ggkogkou/bldc-motor-driver/3D/BLM18PG471SN1D.stp

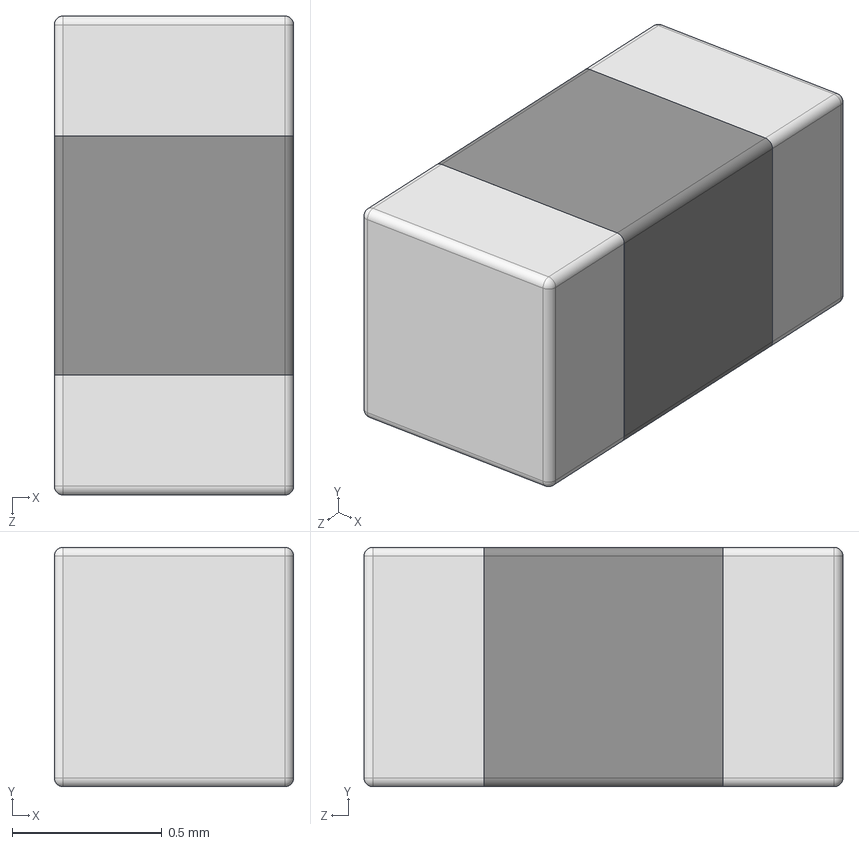
[picture p1: CAD file, 2025-12-28]
3D/BLM18PG471SN1D.stp
0.8 x 0.8 x 1.60 mm
