ggkogkou/bldc-motor-driver/3D/Sandbox/IRLR120NTRPBF.step

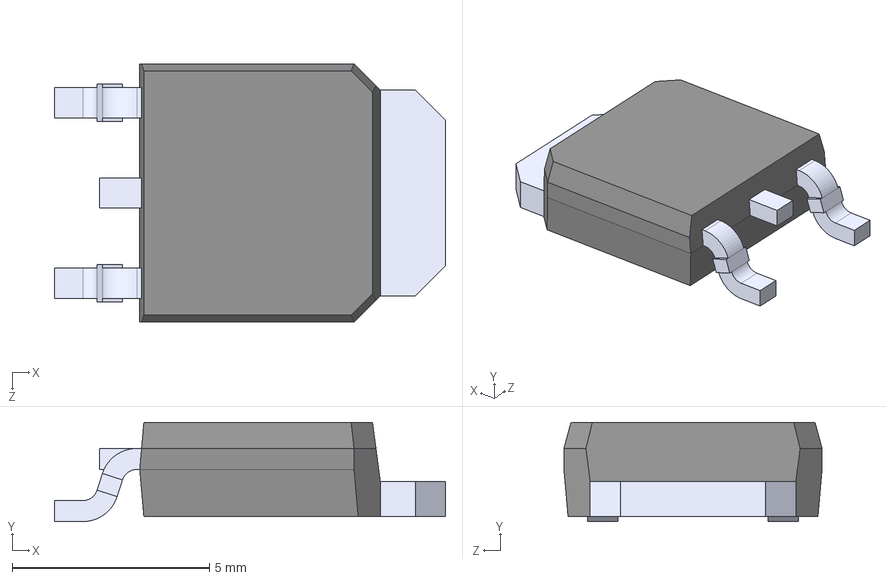
[picture p2: CAD file, 2025-12-05]
3D/Sandbox/IRLR120NTRPBF.step
9.91 x 2.51 x 6.54 mm
