ggkogkou/bldc-motor-driver/3D/Sandbox/IPD320N20N3GATMA1.stp

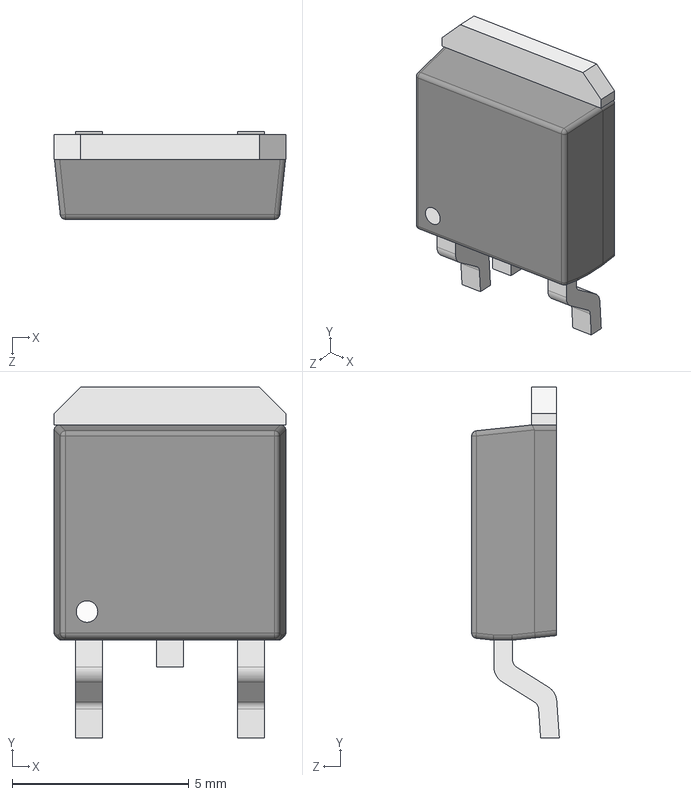
[picture p3: CAD file, 2025-12-05]
3D/Sandbox/IPD320N20N3GATMA1.stp
6.57 x 9.94 x 2.49 mm
