ggkogkou/bldc-motor-driver/3D/Sandbox/STD10NF10T4.stp

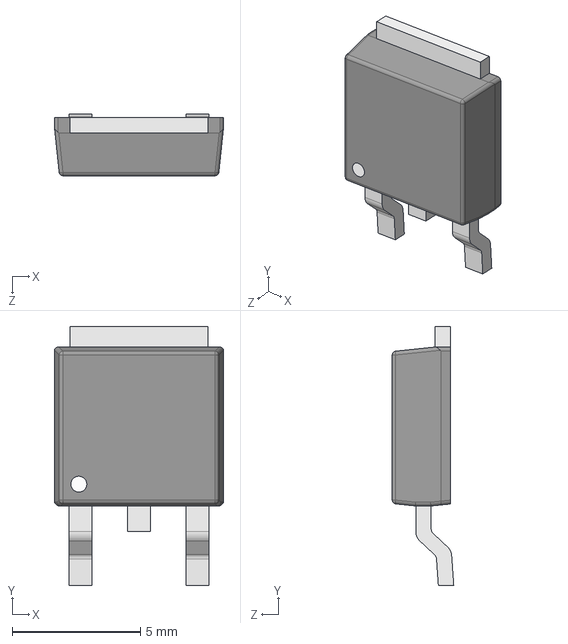
[picture p4: CAD file, 2025-12-05]
3D/Sandbox/STD10NF10T4.stp
6.60 x 10.1 x 2.40 mm
