ggkogkou/bldc-motor-driver/3D/Sandbox/USB3135-30-A.stp

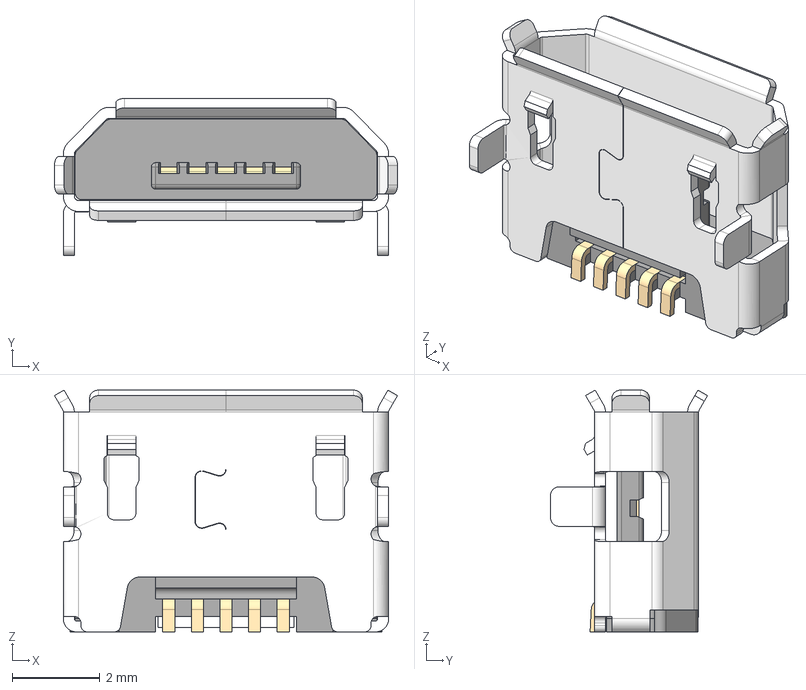
[picture p5: CAD file, 2025-12-05]
3D/Sandbox/USB3135-30-A.stp
7.80 x 3.57 x 5.50 mm
USB3135-30-A_PART1
USB3135-30-A_PART2 x 5
USB3135-30-A_PART3
