ggkogkou/bldc-motor-driver/3D/USB3140-30-0140-1-C.stp

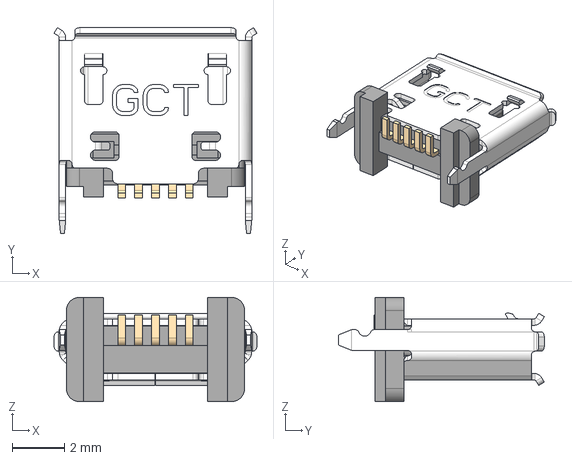
[picture p6: CAD file, 2025-12-12]
3D/USB3140-30-0140-1-C.stp
7.80 x 7.90 x 4.00 mm
