ggkogkou/bldc-motor-driver/3D/AS5047P-ATSM.stp

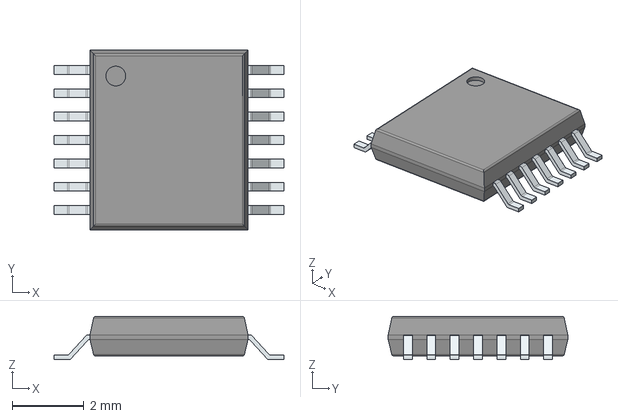
[picture p8: CAD file, 2025-12-03]
3D/AS5047P-ATSM.stp
6.40 x 5.00 x 1.20 mm
PinsArrayLR
