ggkogkou/bldc-motor-driver/3D/ATSAMD21G18A-AFT.stp

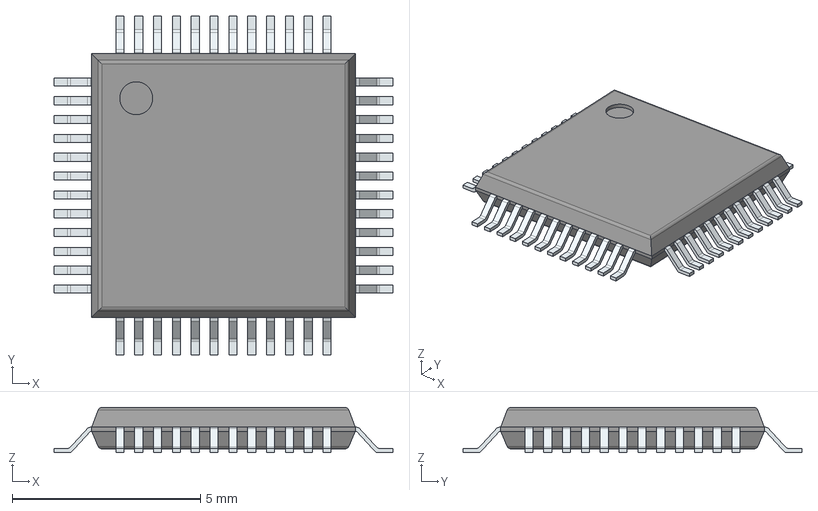
[picture p9: CAD file, 2025-12-03]
3D/ATSAMD21G18A-AFT.stp
9.00 x 9.00 x 1.20 mm
PinsArrayLR
PinsArrayTB
