ggkogkou/bldc-motor-driver/3D/L6498D.stp

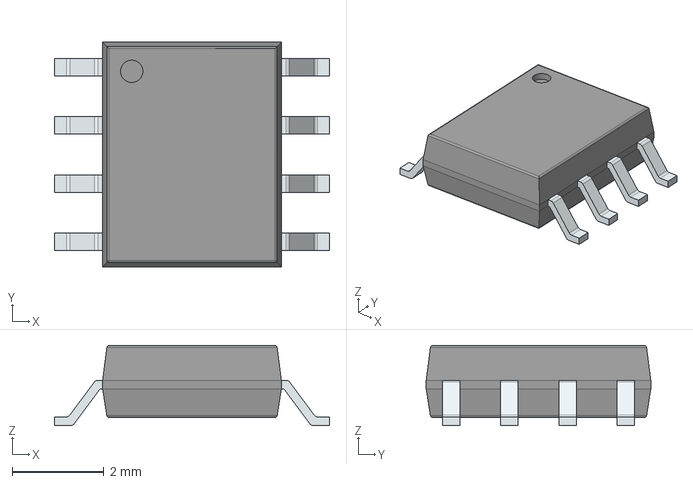
[picture p10: CAD file, 2025-12-03]
3D/L6498D.stp
6.00 x 4.90 x 1.75 mm
PinsArrayLR
