ggkogkou/bldc-motor-driver/3D/IPB320N20N3GATMA1.step

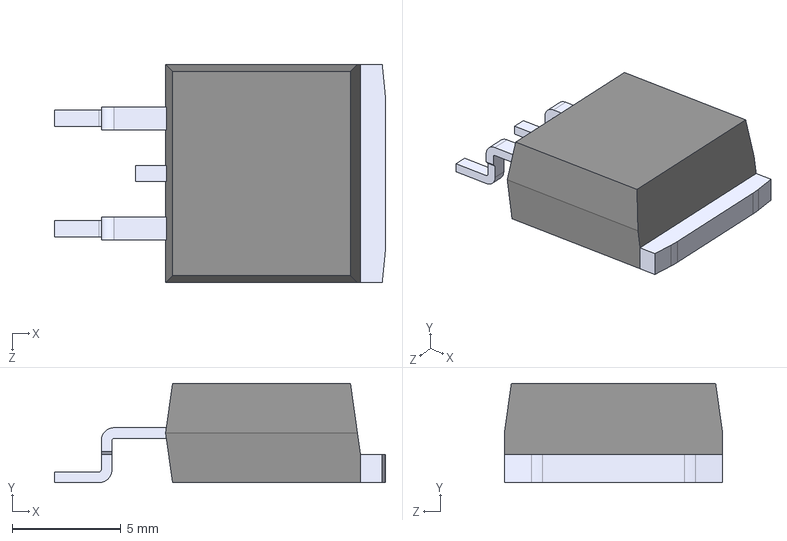
[picture p11: CAD file, 2025-12-03]
3D/IPB320N20N3GATMA1.step
15.2 x 4.57 x 10.1 mm
