ggkogkou/bldc-motor-driver/3D/AD8030ARZ.stp

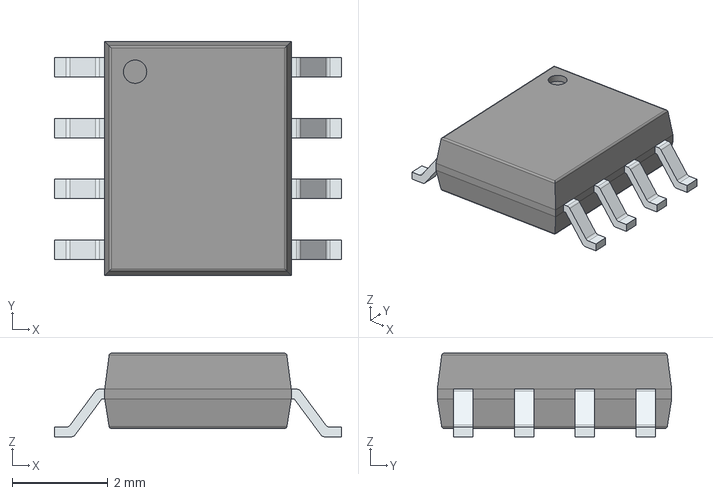
[picture p12: CAD file, 2025-12-03]
3D/AD8030ARZ.stp
6.00 x 4.90 x 1.75 mm
PinsArrayLR
