ggkogkou/bldc-motor-driver/3D/2202010481.stp

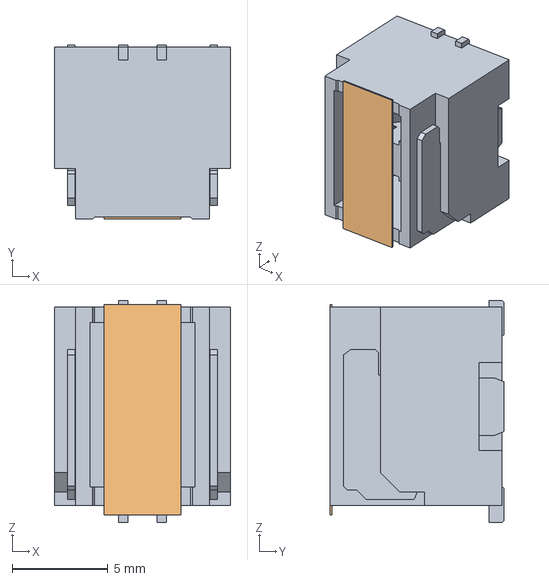
[picture p13: CAD file, 2025-12-12]
3D/2202010481.stp
9.20 x 9.10 x 11.6 mm
