ggkogkou/bldc-motor-driver/3D/2045201221.stp

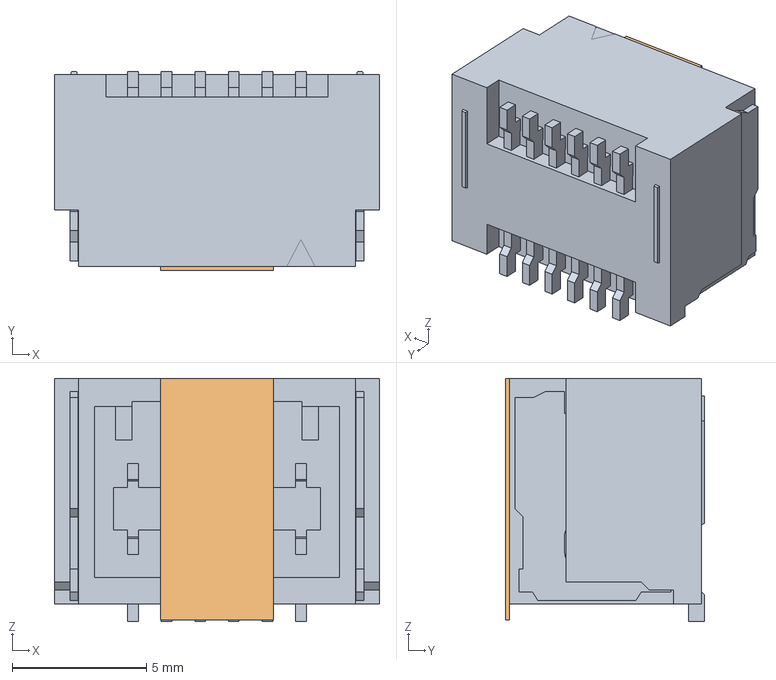
[picture p14: CAD file, 2025-12-12]
3D/2045201221.stp
12.1 x 7.40 x 9.05 mm
