ggkogkou/bldc-motor-driver/3D/505567-0671.stp

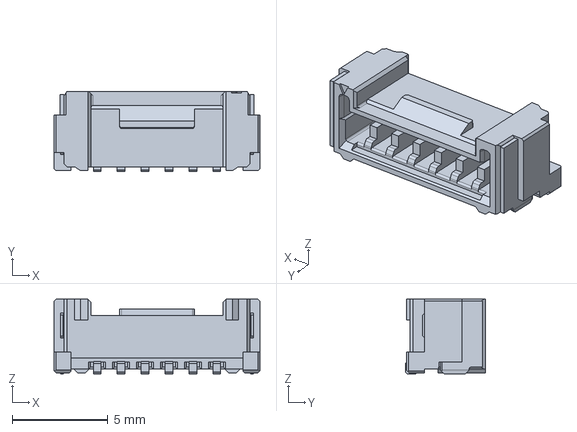
[picture p15: CAD file, 2025-12-12]
3D/505567-0671.stp
10.8 x 4.20 x 3.90 mm
