ggkogkou/bldc-motor-driver/3D/Sandbox/2159310271.stp

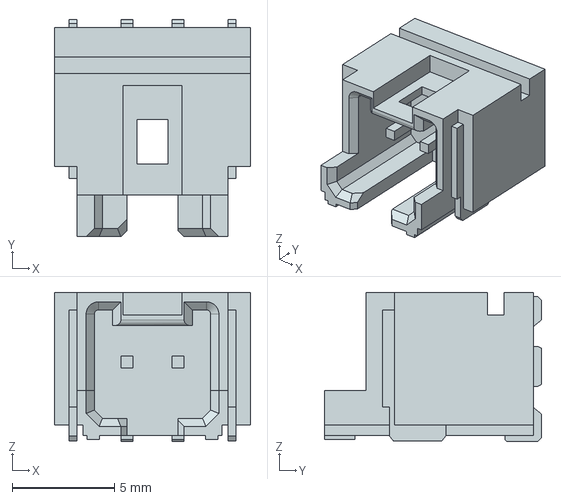
[picture p16: CAD file, 2025-12-05]
3D/Sandbox/2159310271.stp
9.60 x 10.7 x 7.30 mm
