ggkogkou/bldc-motor-driver/3D/505578-0471.stp

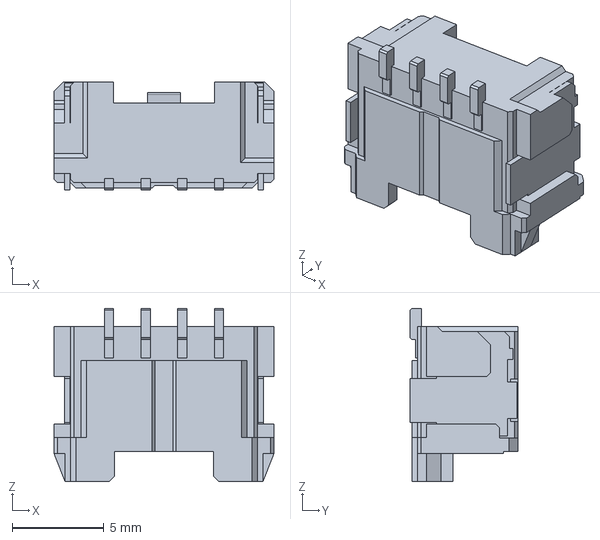
[picture p17: CAD file, 2025-12-12]
3D/505578-0471.stp
12.0 x 5.90 x 9.45 mm
