ggkogkou/bldc-motor-driver/3D/505567-0471.stp

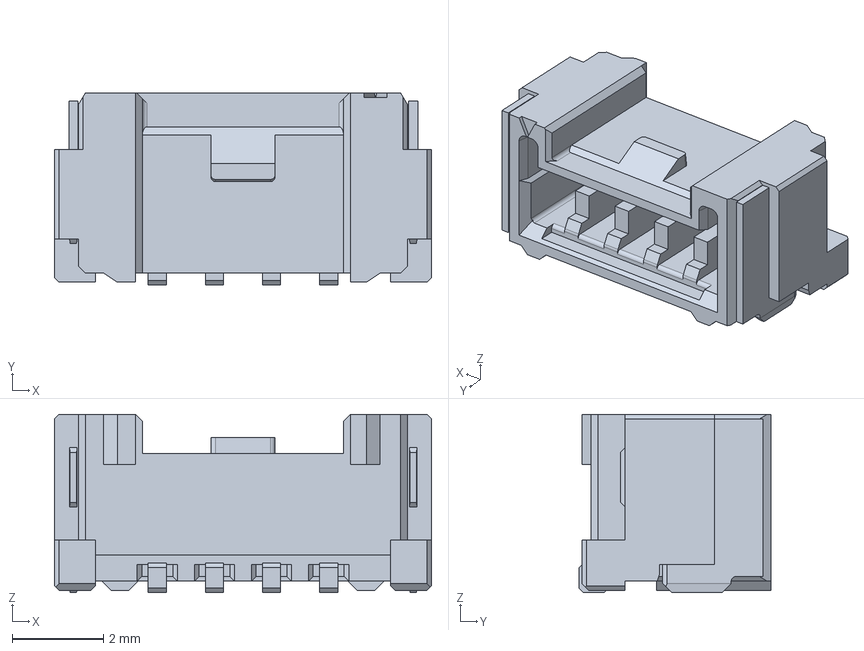
[picture p18: CAD file, 2025-12-12]
3D/505567-0471.stp
8.25 x 4.20 x 3.90 mm
