ggkogkou/bldc-motor-driver/(list of files, cad)

Other CAD files:
3D/2077601281.stp
3D/43650-0303.stp
