ggkogkou/bldc-motor-driver/bldc-driver-pcb.kicad_pcb

## KiCad design bldc-driver-pcb.kicad_pcb (2026-01-25)

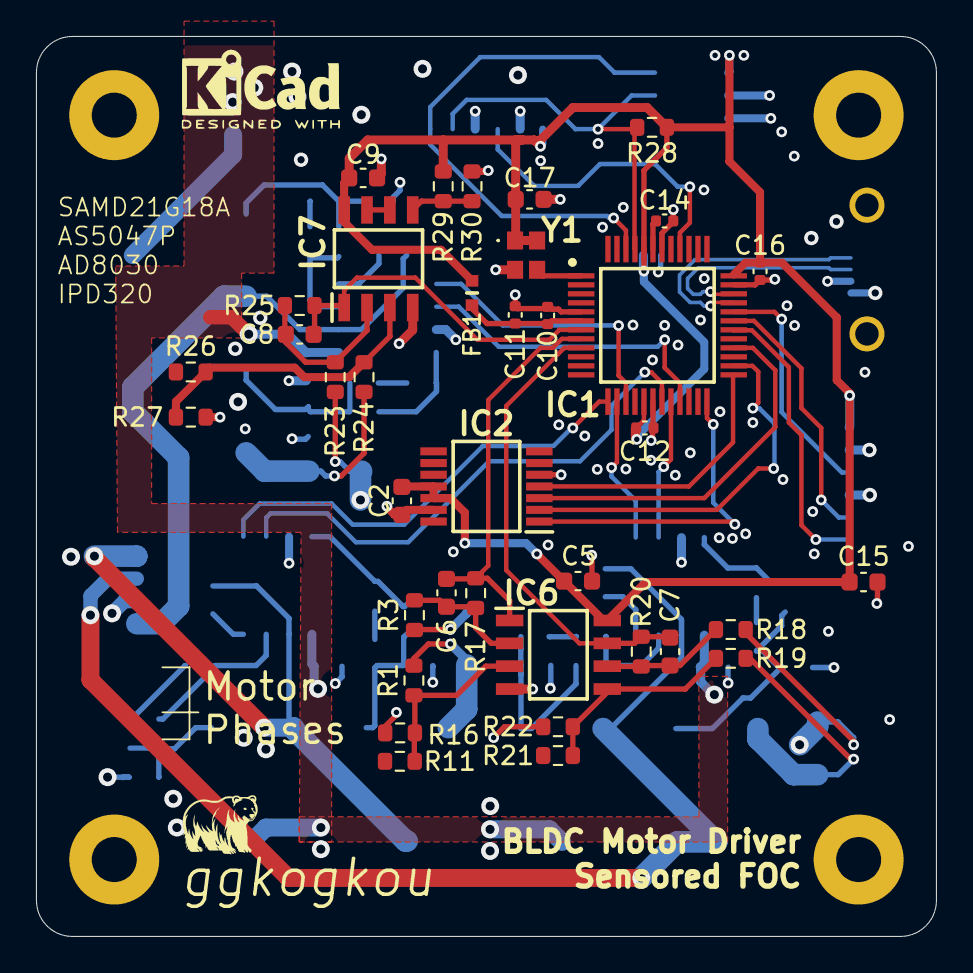
[picture p19: board bldc-driver-pcb.kicad_pcb from above]

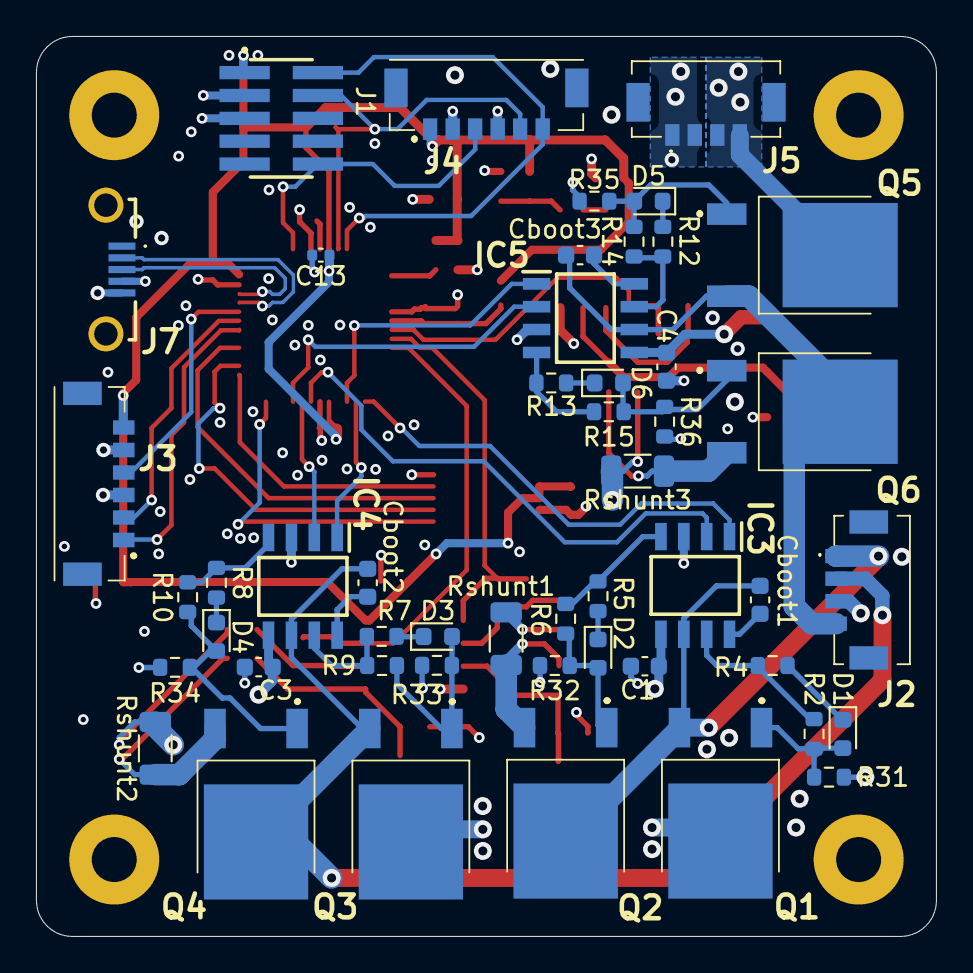
[picture p20: board bldc-driver-pcb.kicad_pcb from below]

Board: 4 copper layers, 50.0 x 50.0 mm, 86 parts (49 on the bottom side), 62 nets.

Parts:
C1, C3, C4: C_Small; C_0603_1608Metric
C2, C5, C9, C17: 0.1u; C_0603_1608Metric
C6, C7, C8: TBD; C_0603_1608Metric
C10, C12, C13, C16: 0.1u; C_0402_1005Metric
C11: 10u; C_0402_1005Metric
C14: 1u; C_0402_1005Metric
C15: 10u; C_0603_1608Metric
Cboot1, Cboot2, Cboot3: TBD; C_0603_1608Metric
D1, D2, D3, D4, D5, D6: D_0603_1608Metric
FB1: FerriteBead; BLM18SP221SN1B
IC1: ATSAMD21G18A-AFT; ATSAMD21G18A-QFP
IC2: AS5047P-ATSM; AS5047P
IC3, IC4, IC5: L6498D
IC6, IC7: AD8030ARZ; AD8030
J1: FTSH-105-XX-X-DV; SAMTEC_FTSH-105-XX-X-DV
J2, J5: 505567-0471; 5055670471
J3, J4: 505567-0671; 5055670671
J7: USB3140-30-0170-1-C; USB31403001700C
Q1, Q2, Q3, Q4, Q5, Q6: IPD320N20N3GATMA1; BTS3035TFATMA1
R1, R3, R11, R16, R17, R18, R19, R20, R21, R22, R23, R24, R25, R26, R27, R29, R30, R31, R32, R33, R34, R35, R36: 10k; R_0603_1608Metric
R2, R4, R5, R6, R7, R8, R9, R10, R12, R13, R14, R15: TBD; R_0603_1608Metric
R28: 1k; R_0603_1608Metric
Rshunt1, Rshunt2, Rshunt3: 100m; R_1206_3216Metric
Y1: LFSPXO009686

Connections:
+3V3: C2.1, C5.2, C9.2, C12.1, C13.1, C15.1, C16.1, C17.2, FB1.1, IC1.17 (VDDIO_1), IC1.36 (VDDIO_2), IC1.44 (VDDIN), IC2.11 (VDD), IC2.12 (VDD3V), IC6.8 (+VS), IC7.8 (+VS), J1.01, J3.6, J4.1, R28.1, R29.1, Y1.1 (TRI-STATE_OPERATION), Y1.4 (+VS)
/Current Sensing/CSA_1_IN+: Q2.3 (S), R1.2, Rshunt1.1
/Current Sensing/CSA_1_VOUT: C6.2, IC1.8 (PB09), IC6.1 (VOUT1), R17.2
/Current Sensing/CSA_2_IN+: Q4.3 (S), R19.1, Rshunt2.1
/Current Sensing/CSA_2_VOUT: C7.1, IC1.9 (PA04), IC6.7 (+VOUT_2), R20.1
/Current Sensing/CSA_3_IN+: Q6.3 (S), R24.2, Rshunt3.1
/Current Sensing/CSA_3_VOUT: C8.2, IC1.7 (PB08), IC7.1 (VOUT1), R25.2
/Microcontroller/ENCODER_CSn: IC1.24 (PA15), IC2.1 (CSN)
/Microcontroller/SERCOM1_PAD0: IC1.25 (PA16), IC2.4 (MOSI)
/Microcontroller/SERCOM1_PAD1: IC1.26 (PA17), IC2.2 (CLK)
/Microcontroller/SERCOM1_PAD3: IC1.28 (PA19), IC2.3 (MISO)
/Microcontroller/TCC0_WO0: IC1.13 (PA08), IC3.1 (HIN)
/Microcontroller/TCC0_WO1: IC1.14 (PA09), IC4.1 (HIN)
/Microcontroller/TCC0_WO2: IC1.15 (PA10), IC5.1 (HIN)
/Microcontroller/TCC0_WO4: IC1.19 (PB10), IC3.2 (LIN)
/Microcontroller/TCC0_WO5: IC1.20 (PB11), IC4.2 (LIN)
/Microcontroller/TCC0_WO6: IC1.21 (PA12), IC5.2 (LIN)
/Microcontroller/USB_D+: IC1.34 (PA25), J7.3 (D+)
/Microcontroller/USB_D-: IC1.33 (PA24), J7.2 (D-)
/Microcontroller/VDDANA: C10.1, C11.1, FB1.2, IC1.6 (VDDANA)
/Microcontroller/VDDCORE: C14.1, IC1.43 (VDDCORE)
/Microcontroller/XIN32: IC1.1 (PA00), Y1.3 (OUTPUT)
/SWCLK: IC1.45 (PA30), J1.04, J4.5, R28.2
/SWDIO: IC1.46 (PA31), J1.02, J4.6
/Three-Phase Inverter/HALF_BRIDGE_1_OUT: Cboot1.2, IC3.6 (OUT), J2.1, Q1.3 (S), Q2.2 (D)
/Three-Phase Inverter/HALF_BRIDGE_2_OUT: Cboot2.2, IC4.6 (OUT), J2.2, Q3.3 (S), Q4.2 (D)
/Three-Phase Inverter/HALF_BRIDGE_3_OUT: Cboot3.2, IC5.6 (OUT), J2.4, Q5.3 (S), Q6.2 (D)
/USART3_Rx: IC1.31 (PA22), J3.2
/USART3_Tx: IC1.32 (PA23), J3.4
/USART5_Tx: IC1.30 (PA21), J3.1
/nRST: IC1.40 (~RESET), J1.10, J4.3
GND: C1.1, C2.2, C3.1, C4.1, C5.1, C9.1, C10.2, C11.2, C12.2, C13.2, C14.2, C15.2, C16.2, C17.1, IC1.5 (GNDANA), IC1.18 (GND_1), IC1.35 (GND_2), IC1.42 (GND_3), IC2.5 (TEST), IC2.13 (GND), IC3.3 (GND), IC4.3 (GND), IC5.3 (GND), IC6.4 (-VS), IC7.4 (-VS), J1.03, J1.05, J2.3, J3.3, J3.5, J4.2, J4.4, J5.1, J5.2, J7.4 (ID), J7.5 (GND), J7.MH2, R3.1, R16.2, R18.2, R22.1, R23.1, R27.2, R30.2, R31.2, R32.2, R33.2, R34.2, R35.2, R36.2, Rshunt1.2, Rshunt2.2, Rshunt3.2, Y1.2 (GND)
unnamed: D1.2 (A), Q1.1 (G), R2.2, R31.1
unnamed: D1.1 (K), R4.2
unnamed: D2.2 (A), Q2.1 (G), R6.2, R32.1
unnamed: D2.1 (K), R5.2
unnamed: D3.2 (A), Q3.1 (G), R9.2, R33.1
unnamed: D3.1 (K), R7.2
unnamed: D4.2 (A), Q4.1 (G), R10.2, R34.1
unnamed: D4.1 (K), R8.2
unnamed: D5.2 (A), Q5.1 (G), R14.2, R35.1
unnamed: D5.1 (K), R12.2
unnamed: D6.2 (A), Q6.1 (G), R15.2, R36.1
unnamed: D6.1 (K), R13.2
unnamed: Cboot1.1, IC3.8 (BOOT)
unnamed: IC3.7 (HVG), R2.1, R4.1
unnamed: IC3.4 (LVG), R5.1, R6.1
unnamed: Cboot2.1, IC4.8 (BOOT)
unnamed: IC4.7 (HVG), R7.1, R9.1
unnamed: IC4.4 (LVG), R8.1, R10.1
unnamed: Cboot3.1, IC5.8 (BOOT)
unnamed: IC5.7 (HVG), R12.1, R14.1
unnamed: IC5.4 (LVG), R13.1, R15.1
unnamed: IC6.3 (+IN_1), R1.1, R11.2, R16.1
unnamed: IC6.5 (+IN_2), R19.2, R21.1, R22.2
unnamed: C6.1, IC6.2 (-IN_1), R3.2, R17.1
unnamed: C7.2, IC6.6 (-IN_2), R18.1, R20.2
unnamed: IC7.3 (+IN_1), R24.1, R26.2, R27.1
unnamed: IC7.5 (+IN_2), R29.2, R30.1
unnamed: IC7.6 (-IN_2), IC7.7 (+VOUT_2)
unnamed: C8.1, IC7.2 (-IN_1), R23.2, R25.1
VBUS: C1.2, C3.2, C4.2, IC3.5 (VCC), IC4.5 (VCC), IC5.5 (VCC), J5.3, J5.4, Q1.2 (D), Q3.2 (D), Q5.2 (D)
