ggkogkou/bldc-motor-driver/(commit log)

2025-12-04 Add MCU stuff, cortex debug connector and docs
    [FTSH-105-01-L-DV-K.stp, bldc-driver-pcb.kicad_sch, current_sensing.kicad_sch, encoder.kicad_sch, inverter.kicad_sch, mcu.kicad_sch]
2025-12-04 Connect unused op amp channel
    [current_sensing.kicad_sch]
2025-12-04 Add gitignore
    [current_sensing.kicad_sch, mcu.kicad_sch]
2025-12-05 Initial routing
    [2159310271.stp, 43650-0303.stp, IPD320N20N3GATMA1.stp, IRLR120NTRPBF.step, STD10NF10T4.stp, USB3135-30-A.stp, bldc-driver-pcb.kicad_pcb, bldc-driver-pcb.kicad_sch]
2025-12-05 Minor changes
    [bldc-driver-pcb.kicad_pcb]
2025-12-08 More routing
    [bldc-driver-pcb.kicad_pcb, bldc-driver-pcb.kicad_sch, inverter.kicad_sch, mcu.kicad_sch]
2025-12-11 Reroute everything
    [bldc-driver-pcb.kicad_pcb, bldc-driver-pcb.kicad_sch]
2025-12-12 Finalize layout -- VREF pending
    [2045201221.stp, 2077601281.stp, 2202010481.stp, 505567-0471.stp, 505567-0671.stp, 505578-0471.stp, USB3140-30-0140-1-C.stp, bldc-driver-pcb.kicad_pcb]
2025-12-12 Add connector for motor phases
    [bldc-driver-pcb.kicad_pcb, bldc-driver-pcb.kicad_sch, inverter.kicad_sch]
2025-12-12 Fix DRC violations
    [bldc-driver-pcb.kicad_pcb]
2025-12-12 Add some silkscreen
    [bldc-driver-pcb.kicad_pcb]
2025-12-28 Relocate VM & phase connectors
    [bldc-driver-pcb.kicad_pcb, bldc-driver-pcb.kicad_sch]
2025-12-28 Add 32.768kHz external clock & specify ferrite bead part number
    [BLM18PG471SN1D.stp, bldc-driver-pcb.kicad_pcb, mcu.kicad_sch]
2025-12-28 Vmotor power plane
    [bldc-driver-pcb.kicad_pcb]
2026-01-25 Layout QOL changes
    [bldc-driver-pcb.kicad_pcb]
