ggkogkou/bldc-motor-driver/(notices)

Notices in the files:
3D/Sandbox/USB3135-30-A.stp:
author */ ('License CC BY-ND 4.0'),
